blinken/power-rail-probe/(notices)

Notices in the files:
low-noise-power-probe.kicad_sch:
Copyright BLINKENLIGHT Ltd - blinkenlight.co.uk
Open Hardware released under the CC BY-SA 3.0 license
